eSpark-Backup/anzora-slanukov-design-review/Design Files/QuickSwitchV5-v1.2/Deliverables/Renderings/Isometric.png

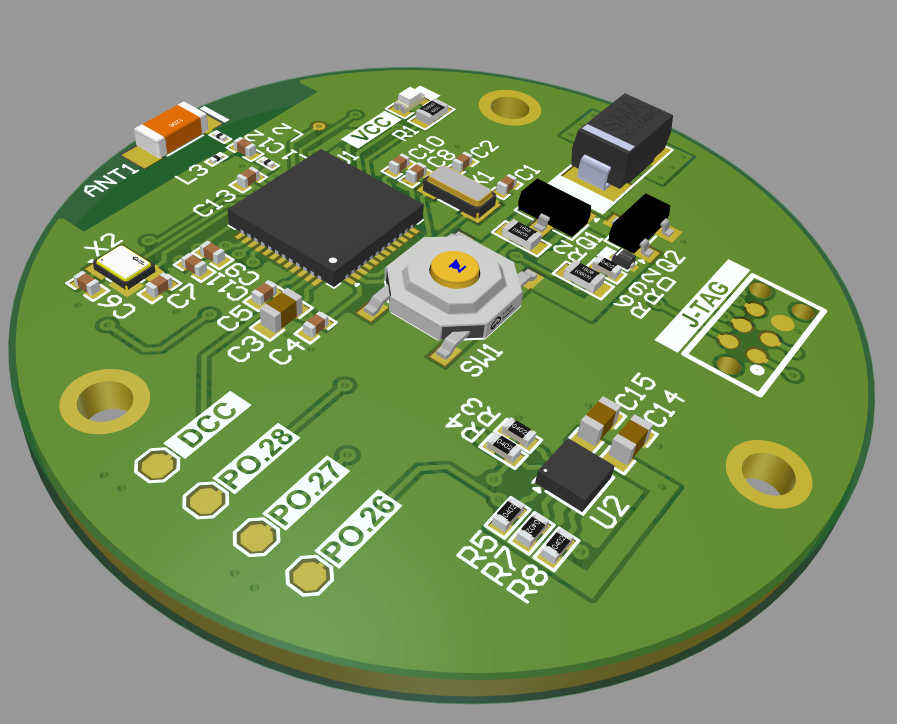
Design Files/QuickSwitchV5-v1.2/Deliverables/Renderings/Isometric.png
