eSpark-Backup/anzora-slanukov-design-review/docs/Client-Files/Original-Design/quickswitch_v5_requirements.docx

Project Overview

QuickSwitch (abbreviated QS) is a Bluetooth door movement detector that is able to detect when a door moves using an accelerometer (LIS2DW12TR) and send keyboard signals to a connected device. When QS detects door movement, it sends keyboard commands Alt+Tab or Cmd+Tab depending on the operating system of the device it is connected to. The QS is meant to operate in low-power mode and uses a CR2032 coin cell battery as its power source.

Functional Requirements

Motion Detection

- The device must detect door opening events using the LIS2DW12TR accelerometer.
- The accelerometer must send a signal to the Soc (NRF52832-QFAA-R) when motion is detected.
- The accelerometer must run in ultra-low power mode.
- The accelerometer must wake-up upon motion being detected.
- The accelerometer must trigger an interrupt to the SoC when motion is detected.
  - During motion detection, the SoC will transition from sleep mode to full power mode.

Bluetooth Communication

- The device must remain connected to the paired device via Bluetooth Low Energy (BLE) at all times unless disconnected by user.
- The device must send a Bluetooth HID signal to simulate Alt+Tab (Windows) or Cmd+Tab (macOS) upon motion detection.

User Input Control

- The device must have a push button to initiate power-on, start-up, and pairing mode selection.
- The device must allow SoC to control shutdown after a set period of inactivity.

Power Management

- The device must use a P-Channel MOSFET latch circuit to manage power efficiently.
- It must be able to latch ON when powered up and shut OFF via firmware control.
- The device must consume minimal current when idle or in standby.

Status Indication

- The device must have a blue LED to indicate power status and pairing mode.

Firmware Update Support

- The device must have a TC2030 programming interface for SWD flashing
- The SoC must support crystal oscillators for accurate timing during flashing and operation

Size and Form Factor

- The PCB must be circular in shape.
- The CR2032 battery holder must be on the opposite (bottom) and the components must be on the top side of the PCB.

Safety and Protection

- The device must include a reverse polarity Schottky diode (SS14) to protect components from battery reversal.
- The device must include ESD protection using the component ESD9B3.3ST5G-ES for critical input lines like the power rail.
- RF components must include impedance matching to ensure a stable Bluetooth connection.

Component Sourcing

- The device must source all components from the JLCPCB parts website.
- The components must be in stock, preferably with availability of over 5000 parts.

Step-by-Step Instructions of Operations

Startup (Power ON) Sequence

1. Device OFF: The P-MOSFET gate is HIGH (via 1MΩ pull-up resistor to BATT+), so the P-MOSFET is OFF (no power to VCC).
2. User Presses Button:
  a. Push button connects BATT+ to N-MOSFET gate, turning the N-MOSFET ON.
  b. N-MOSFET pulls P-MOSFET gate LOW, turning it ON.
  c. Power flows to VCC, SoC powers up.
3. SoC Botts Up:
  a. SoC sets GPIO HIGH to keep N-MOSFET ON, even after button is released.
  b. This latches the power ON.

Shutdown (Power OFF) Sequence

1. SoC sets GPIO LOW:
  a. N-MOSFET turns OFF.
  b. P-MOSFET gate floats HIGH via 1MΩ pull-up.
  c. P-MOSFET turns OFF, cutting power to VCC.
2. Device is now fully OFF, consuming near-zero power.
