eSpark-Backup/anzora-slanukov-design-review/Design Files/QuickSwitchV5-v1.2/Deliverables/Impedance profile/50 OHM nets.png

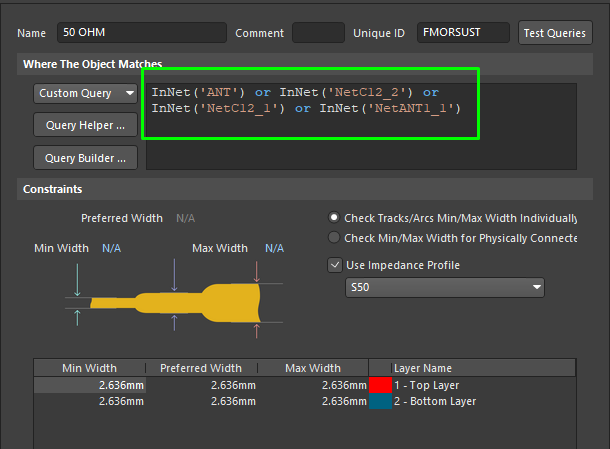
Design Files/QuickSwitchV5-v1.2/Deliverables/Impedance profile/50 OHM nets.png
