eSpark-Backup/anzora-slanukov-design-review/Design Files/QuickSwitchV5-v1.2/Deliverables/Impedance profile/50 OHM.png

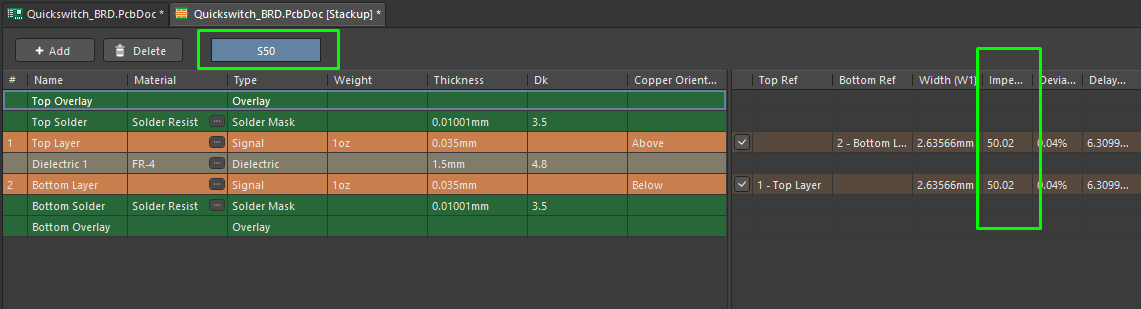
Design Files/QuickSwitchV5-v1.2/Deliverables/Impedance profile/50 OHM.png
