eSpark-Backup/anzora-slanukov-design-review/Design Files/QuickSwitchV5-v1.2/Deliverables/Renderings/2D-View.png

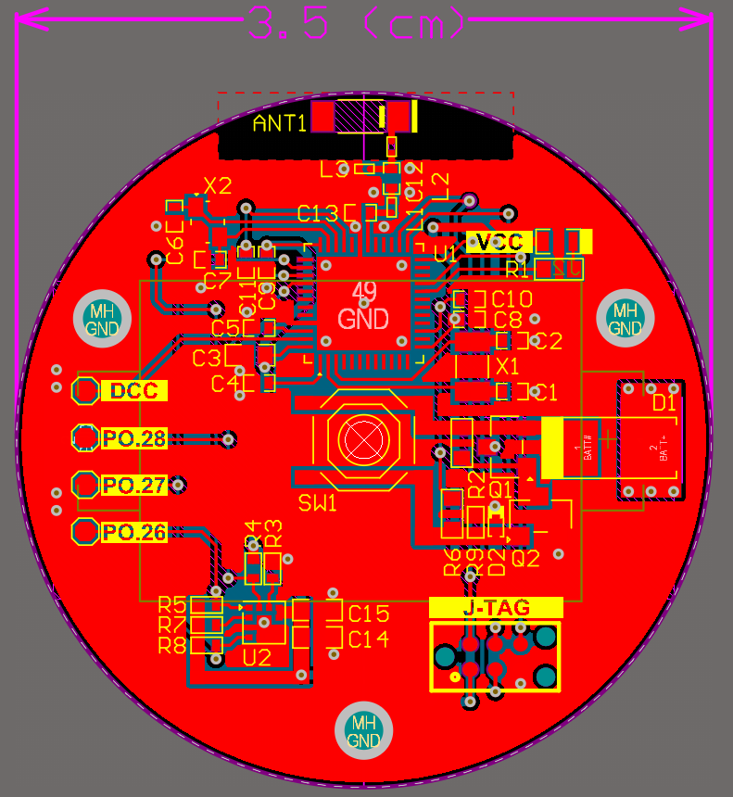
Design Files/QuickSwitchV5-v1.2/Deliverables/Renderings/2D-View.png
