eSpark-Backup/anzora-slanukov-design-review/Design Files/QuickSwitchV5-v1.2/Deliverables/Renderings/3D-BottomView.png

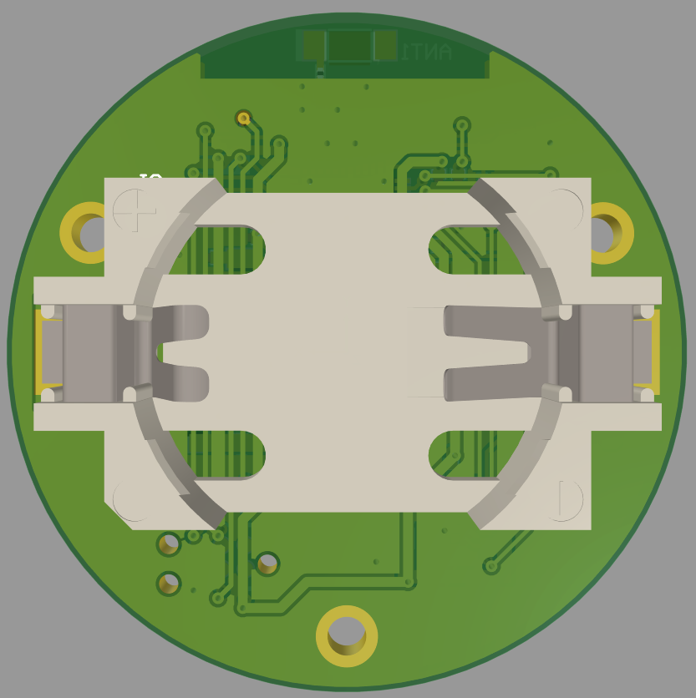
Design Files/QuickSwitchV5-v1.2/Deliverables/Renderings/3D-BottomView.png
