eSpark-Backup/anzora-slanukov-design-review/Design Files/QuickSwitchV5-v1.2/BOM/Client_BOM.xlsx

# | Item Type | Designator | Description | Footprint | Manufacturer Part Number | Manufacturer | Value | Quantity | Remarks
1 | Antenna | ANT1 | RF ANT 2.4GHZ CHIP SOLDER SMD | ANT-1206 | 2450AT18B100E | Johanson | - | 1
2 | Capacitors | ~~C1, C2~~ | ~~CAP CER 13PF 50V C0G/NP0 0402~~ | ~~Cap-0402~~ | ~~CC0402FRNPO9BN130~~ | ~~Yageo~~ | ~~DNP~~ | ~~2~~ | ~~DO NOT PLACE~~
3 | Capacitors | C3 | CAP CER 4.7UF 25V X5R 0603 | Cap-0603 | GRM188R61E475KE11D | Murata | 4.7uF | 1
4 | Capacitors | C4, C8, C9, C10 | CAP CER 0.1UF 50V X7R 0402 | cap-0402 | C1005X7R1H104KT000F | TDK | 100nF | 4
5 | Capacitors | C5 | CAP CER 1UF 16V X5R 0402 | Cap-0402 | CC0402KRX5R7BB105 | Yageo | 1uF | 1
6 | Capacitors | C6, C7 | CAP CER 10PF 50V C0G/NP0 0402 | Cap-0402 | GRM1555C1H100JA01D | Murata | 10pF | 2
7 | Capacitors | C11 | CAP CER 100PF 50V C0G/NP0 0402 | Cap-0402 | 04025A101JAT2A | Kyocera AVX | 100pF | 1
8 | Capacitors | C12 | CAP CER 2.2PF 50V C0G/NP0 0402 | Cap-0402 | GRM1555C1H2R2BA01D | Murata | 2.2pF | 1
9 | Capacitors | C13 | CAP CER 0.8PF 50V C0G/NPO 0402 | Cap-0402 | CC0402BRNPO9BNR80 | Yageo | 0.8pF | 1
10 | Capacitors | C14 | CAP CER 0.1UF 50V Y5V 0603 | Cap-0603 | CC0603ZRY5V9BB104 | Yageo | 0.1uF | 1
11 | Capacitors | C15 | 10V 10uF X5R ±10% 0603 Multilayer Ceramic Capacitors MLCC - SMD/SMT ROHS | Cap-0603 | CGA0603X5R106K100JT | HRE | 10uF | 1
12 | Diode | D1 | 40V Independent Type 1A 550mV@1A SMA(DO-214AC) Schottky Diodes ROHS | SMA(DO-214AC) | SS14 | MDD(Microdiode Semiconductor) | - | 1
13 | Diode | D2 | 6A 80W 10V 3.7V Bidirectional 3.3V SOD-923 ESD and Surge Protection (TVS/ESD) ROHS | SOD-923. | ESD9B3.3ST5G-ES | ElecSuper | - | 1
14 | Connector | ~~J1~~ | ~~-~~ | ~~Custom~~ | ~~-~~ | ~~-~~ | ~~DNP~~ | ~~1~~ | ~~DO NOT PLACE~~
15 | Connector | J2 | Battery base CR2032 SMD Battery Connectors ROHS | Custom | CR2032-BS-6-1 | Q&J | - | 1
16 | Inductors | L1, L2 | FIXED IND 3.9NH 350MA 350MOHM SM | IND-0201 | LQP03TG3N9B02D | Murata | 3.9nH | 2
17 | Inductor | ~~L3~~ | ~~FIXED IND 2.7NH 500MA 200MOHM SM~~ | ~~IND-0201~~ | ~~LQP03TN2N7B02D~~ | ~~Murata~~ | ~~DNP~~ | ~~1~~ | ~~DO NOT PLACE~~
18 | LED | LED1 | 20mA 300mcd Colorless Transparent Lens -20℃~+85℃ Positive Stick 455nm~475nm Blue 120° 70mW 3.3V 0603 LED Indication - Discrete ROHS | LED-0603 | XL-1608UBC-04 | XINGLIGHT | - | 1
19 | Mosfet | Q1 | Trans Mosfet P-ch 30V 4A 3-PIN SOT-23 T/r | SOT-23 | AO3401A | Alpha & Omega Semiconductor | - | 1
20 | Mosfet | Q2 | MOSFET N-CH 50V 200MA SOT-23 | SOT-23 | BSS138LT1G | ON Semiconductor | - | 1
21 | Resistor | R1 | 100mW Thick Film Resistors 75V ±100ppm/℃ ±1% 330Ω 0603 Chip Resistor - Surface Mount ROHS | Res-0603 | 0603WAF3300T5E | Royal Electronic Factory | 330R | 1
22 | Resistor | R2 | 100mW Thick Film Resistors ±100ppm/℃ ±1% 1MΩ 0603 Chip Resistor - Surface Mount ROHS | Res-0603 | 0603WAF1004T5E | UNI-ROYAL(Uniroyal Elec) | 1M | 1
23 | Resistor | R3, R4, R7, R9 | RES SMD 10K OHM 0.5% 1/16W 0402 | Res-0402 | RE0402DRE0710KL | Yageo | 10K | 4
24 | Resistor | R5, R8 | RES 4.7K OHM 1% 1/16W 0402 | Res-0402 | RC0402FR-074K7L | Yageo | 4.7K | 2
25 | Resistor | R6 | RES 470 OHM 1% 1/10W 0603 | Res-0603 | RC0603FR-07470RL | Yageo | 470R | 1
26 | Switch | SW1 | None Without bracket 50mA 5.1mm 100000 Times 160gf 12V 5.1mm 1.5mm Round Button Standing paste SPST SMD Tactile Switches ROHS | Custom | TS-1187A-B-A-B | XKB | - | 1
27 | IC | U1 | IC RF TXRX+MCU BLE 48QFN | QFN-48-EP(6x6) | NRF52832-QFAA-R | Nordic Semiconductor | - | 1
28 | IC | U2 | ACCEL 2-16G I2C/SPI 12LGA | 12-LGA (2x2) | LIS2DW12TR | STMicroelectronics | - | 1
29 | ~~Crystals~~ | ~~X1~~ | ~~32.768kHz Surface Mount Crystal 12.5pF ±20ppm SMD3215-2P Crystals ROHS~~ | ~~SMD3215-2P~~ | ~~Q13FC13500004~~ | ~~Epson~~ | ~~DNP~~ | ~~1~~ | ~~DO NOT PLACE~~
30 | Crystal | X2 | 32MHz Surface Mount Crystal 12pF ±10ppm ±10ppm SMD2016-4P Crystals ROHS | SMD2016-4P | TAXM32M4ZFBCCT2T | Yajingxin | - | 1
31 | Peripheral | - | “No Legs” 6-pin Plug-of-Nails™ Cable fitted with a 6-pin 0.1″ pitch ribbon connector | Custom | TC2030-IDC-NL | Tag-Connect LLC | - | 1 | Tag Connect (https://www.tag-connect.com/product/tc2030-idc-nl)
32 | Peripheral | - | BATTERY LITHIUM 3V COIN 20MM | Custom | CR2032 | - | - | 1 | Aliexpress (https://vi.aliexpress.com/item/1005007515412606.html)
