eSpark-Backup/anzora-slanukov-design-review/docs/Client-Files/Original-Design/qs_components.xlsx

Quantity | JLCPCB Part # | Component Name | Description
1 | C77540 | NRF52832-QFAA-R | nRF SoC
1 | C189624 | LIS2DW12TR | Accelerometer
1 | C14663 | CC0603KRX7R9BB104 | Decoupling Capacitor (C1)
1 | C19702 | CL10A106KP8NNNC | Bulk Capacitor (C2)
2 | C23162 | 0603WAF4701T5E | I²C Pull-up Resistors (R1, R2)
3 | C25804 | 0603WAF1002T5E | 10kΩ Interrupt Pull-up Resistors (R3, R4, Optional) and CS (Chip Select) Pull-up Resistor (R5)
1 | C70377 | CR2032-BS-6-1 | CR2032 Battery Holder
1 | C293767 | ANT3216LL00R2400A | Bluetooth Chip Antenna
1 | C18216 | LQG15HS2N0S02D | Chip Antenna Inductor
1 | C1558 | 0402CG2R0C500NT | C1 Capacitor
1 | C1550 | 0402CG1R0C500NT | C2 Capacitor
1 | C14663 | CC0603KRX7R9BB104 | C3 100nF Capacitor
1 | C965807 | XL-1608UBC-04 | Blue LED
1 | C23138 | 0603WAF3300T5E | 330Ω Resistor
1 | C318884 | TS-1187A-B-A-B | Push Button
1 | C347476 | AO3401A | P-Channel MOSFET
1 | C3008053 | 2N7002K | N-Channel MOSFET
1 | C25804 | 0603WAF1002T5E | 10kΩ Resistor
1 | C25803 | 0603WAF1003T5E | 100kΩ Resistor
1 | C14663 | CC0603KRX7R9BB104 | 100nF Capacitor
1 | C1705 | CL10A475KP8NNNC | 4.7uF Capacitor
1 | C2480 | SS14 | Reverse-Polarity Protection Schottky Diode
1 | C5180230 | ESD9B3.3ST5G-ES | TVS/ESD Surge Protector
1 | C21190 | 0603WAF1001T5E | 1kΩ Resistor
1 | C19702 | CL10A106KP8NNNC | 10uF Decoupling Capacitor
1 | C22935 | 0603WAF1004T5E | 1MΩ Resistor for Gate Pull-Down
1 | C15849 | CL10A105KB8NNNC | 1uF Power Stability Capacitor
1 | C388797 | TAXM32M4ZFBCCT2T | 32 MHz Crystal
2 | C76946 | GRM1555C1H100JA01D | C0G Dielectric 10pF Capacitor
1 | C22935 | 0603WAF1004T5E | 1MΩ latch-up prevention DC resistor
1 | C32346 | Q13FC13500004 | 32.768kHz Surface Mount Crystal
2 | C541433 | CC0402FRNPO9BN130 | 13pF NP0 SMT Capacitor
