eSpark-Backup/anzora-slanukov-design-review/Design Files/QuickSwitchV5-v1.2/Deliverables/Supporting Files/Quickswitch_BRD.step

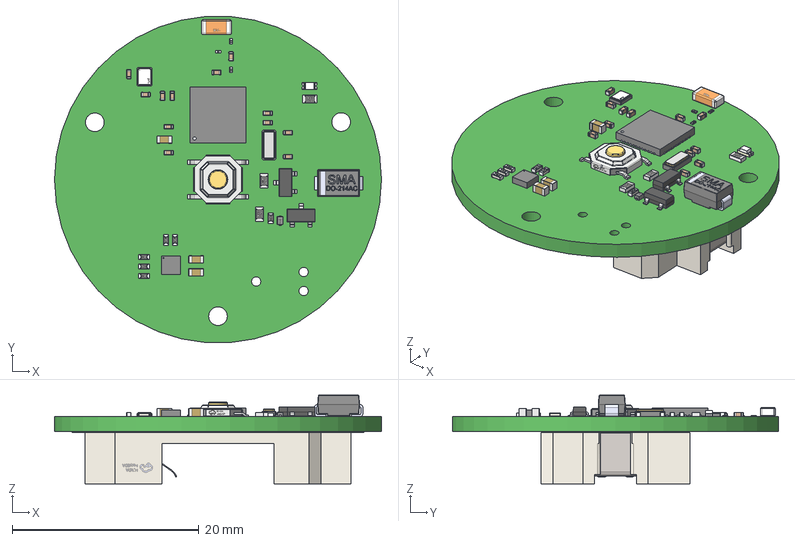
[picture p7: CAD file, 2025-04-03]
Design Files/QuickSwitchV5-v1.2/Deliverables/Supporting Files/Quickswitch_BRD.step
35.0 x 34.9 x 9.49 mm
Ferrite x 3
User Library-NDK_NX3215SA
LIS2DW12TR
User Library-RES_1005-0402 x 6
User Library-RESC1608X05N x 3
CircuitWorks-SOT-23 x 2
User Library-LED SMD0603
SOLID.step
User Library-DIODE_SOD-923
SMA (DO-214AC)
User Library-CAPC1608X09 x 3
User Library-Capacitor 0402 x 12
User Library-1206 SMD Capacitor
