eSpark-Backup/anzora-slanukov-design-review/(list of files, cad)

Other CAD files:
Design Files/QuickSwitchV5-v1.2/Deliverables/Supporting Files/Quickswitch_BRD.DWG
Design Files/QuickSwitchV5-v1.2/Deliverables/Supporting Files/Quickswitch_BRD.DXF
