eSpark-Backup/anzora-slanukov-design-review/docs/Client-Files/Original-Design/full_schematic_v1.pdf

R7

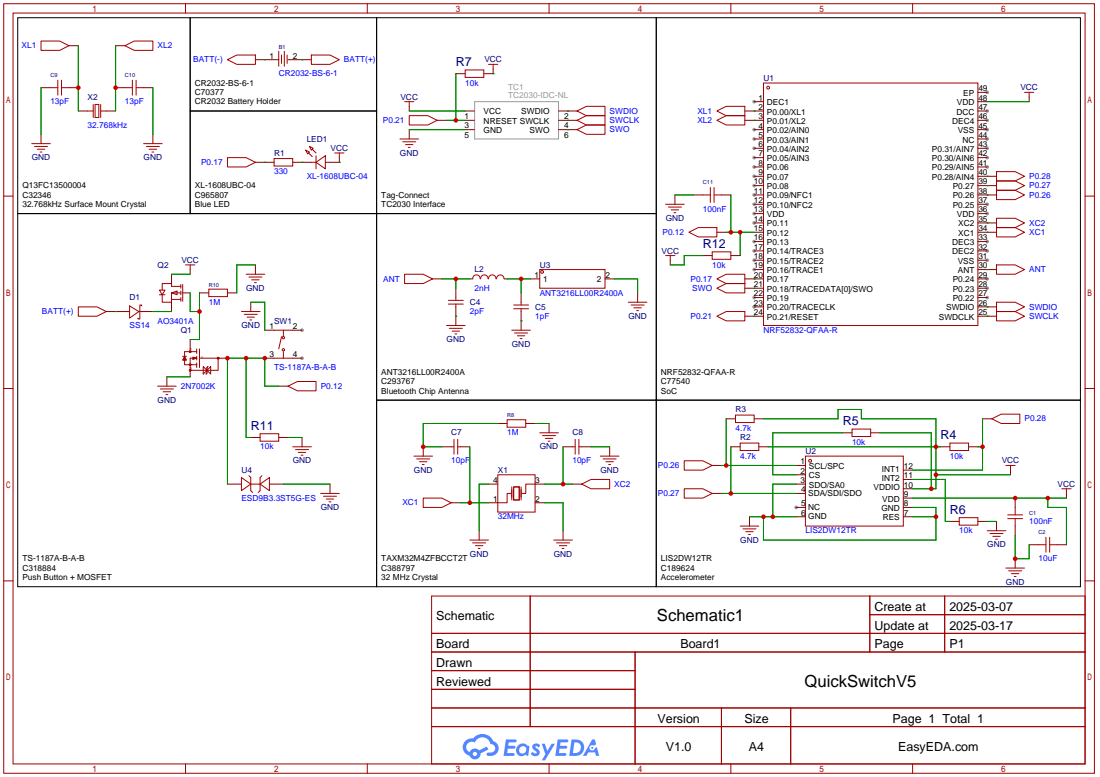
[picture p8: page 1]

Schematic | Schematic1 | Create at | 2025-03-07

Update at | 2025-03-17

Board | Board1 | Page | P1
Drawn | | QuickSwitchV5
Reviewed

Version | Size | Page 1 Total 1
V1.0 | A4 | EasyEDA.com
