eSpark-Backup/anzora-slanukov-design-review/Design Files/QuickSwitchV5-v1.2/Deliverables/Schematics/Assembly Drawings.pdf

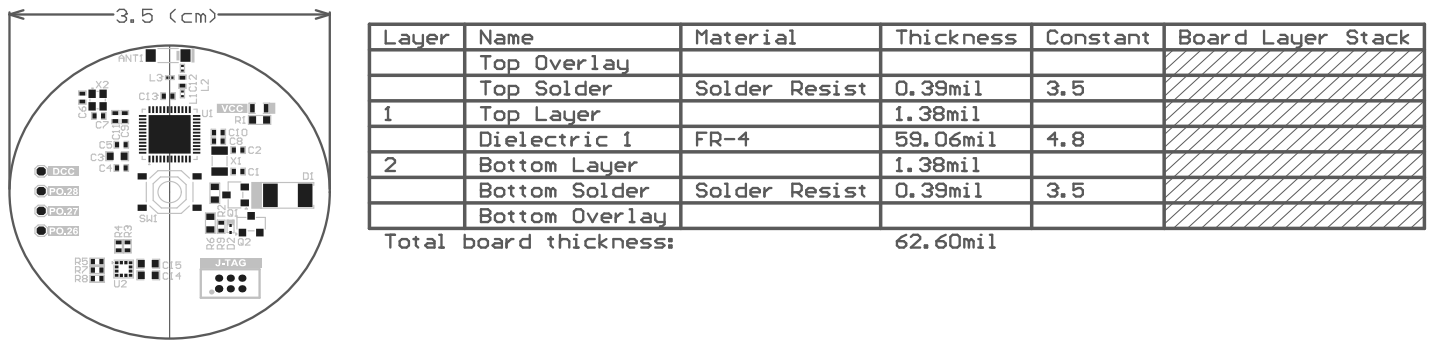
[picture p9: page 1]

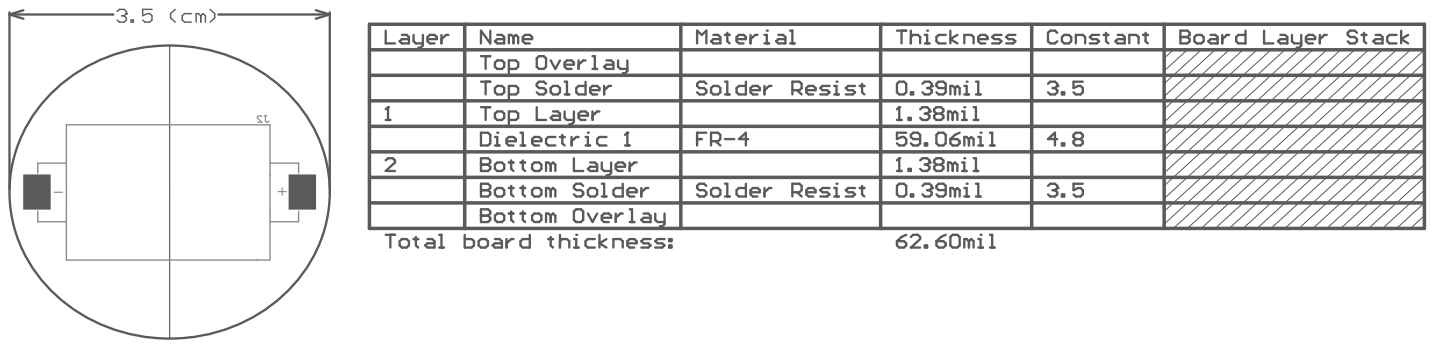
[picture p10: page 2]
