eSpark-Backup/anzora-slanukov-design-review/Design Files/QuickSwitchV5-v1.2/Deliverables/Schematics/quickswitchv5-v1.2.pdf

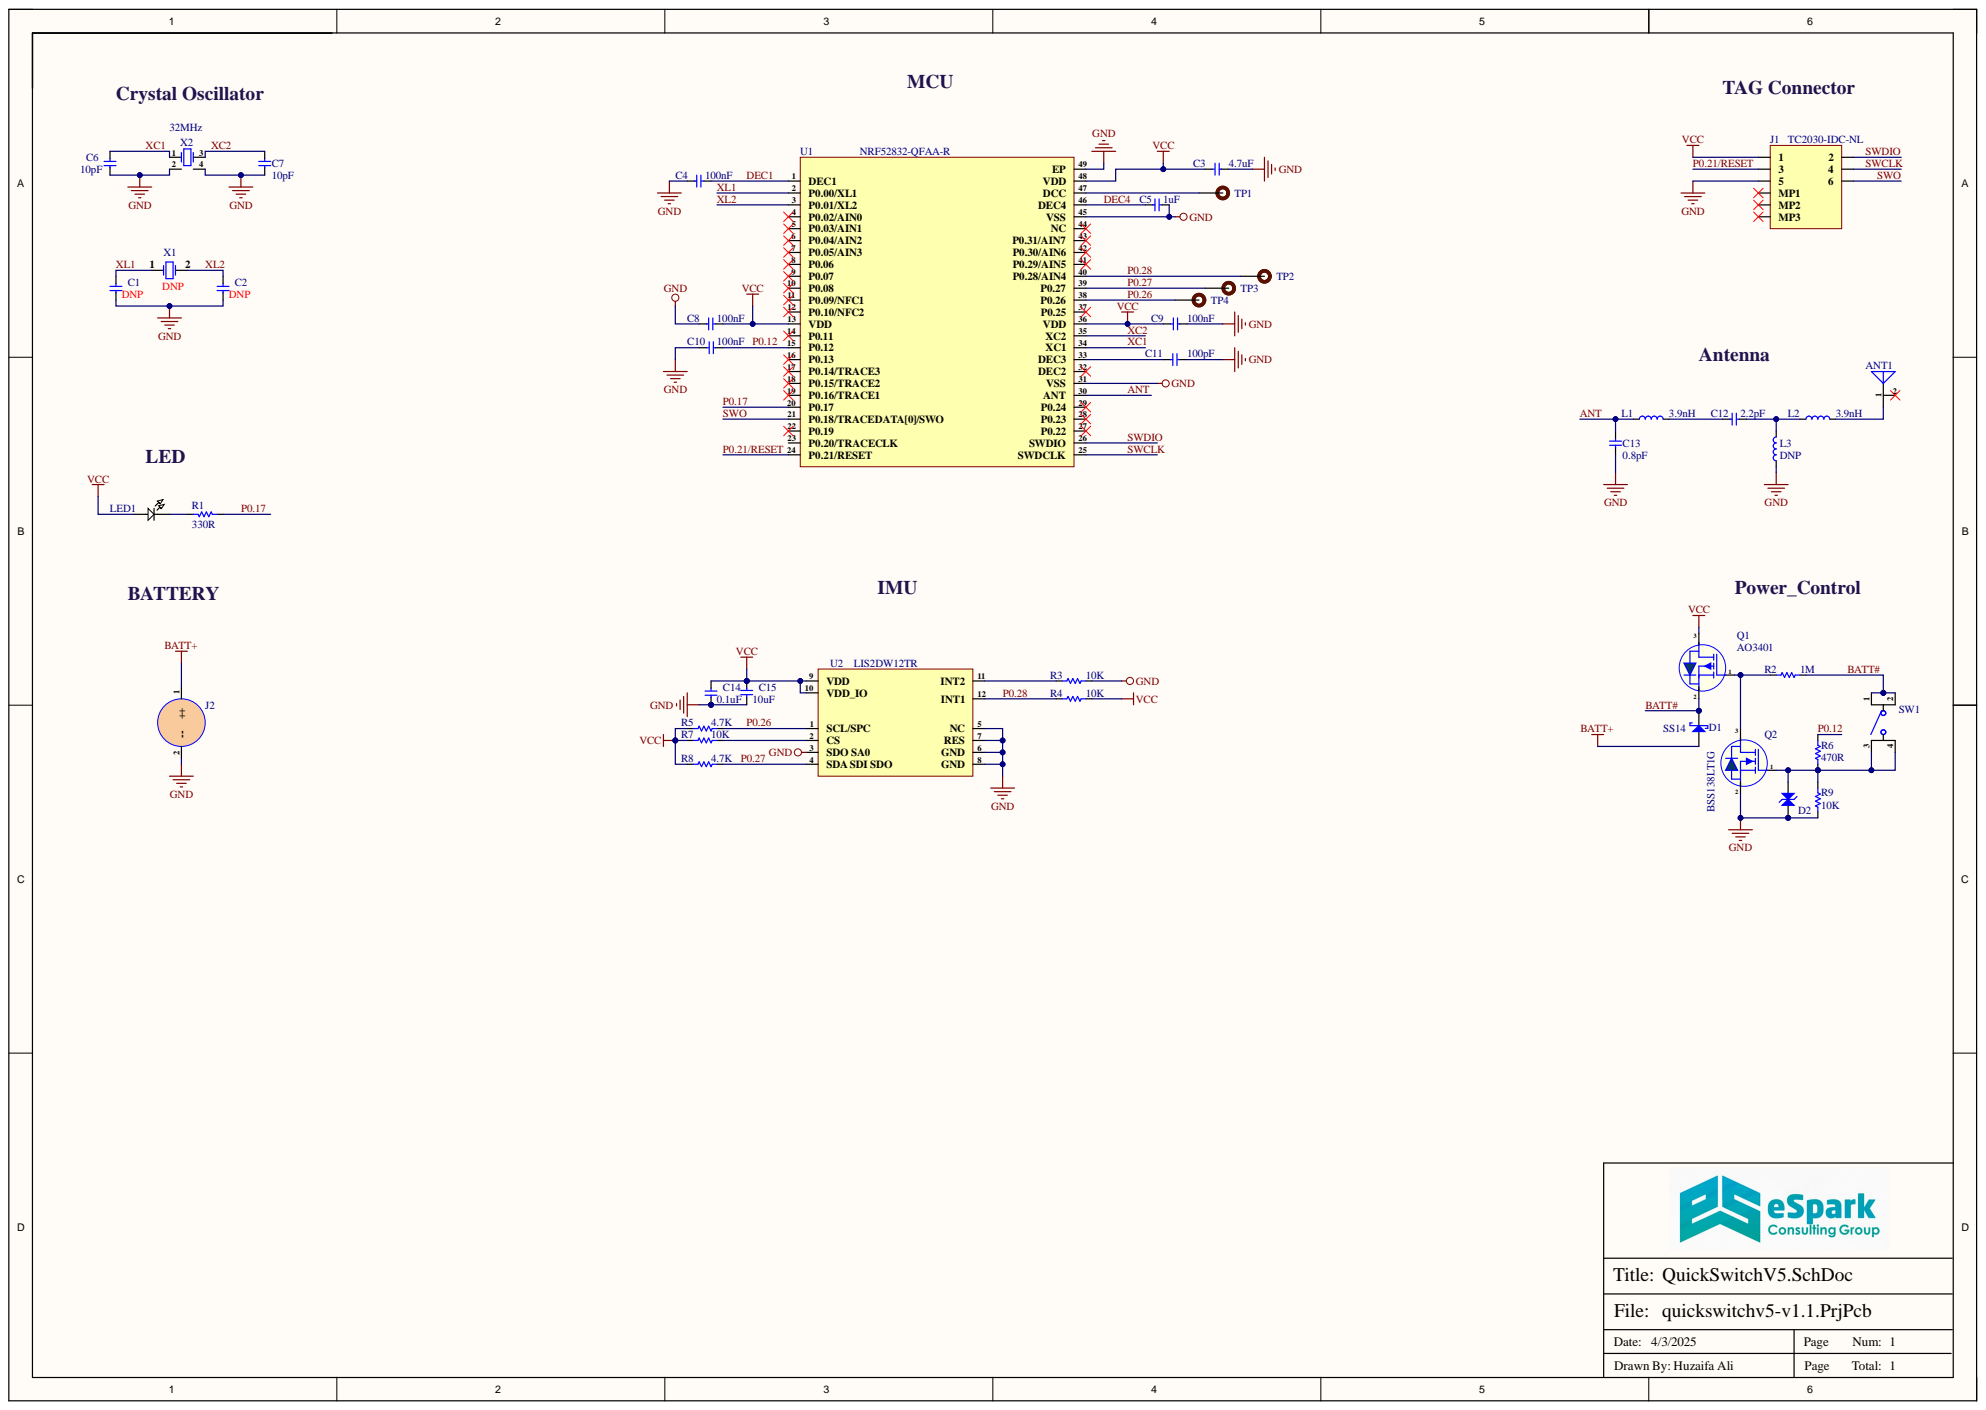
[picture p11: page 1]

Date : 4/3 /2 0 2 5 | Pag e Nu m : 11

Drawn By: Huzaifa Ali | Pag e Total :
