eSpark-Backup/anzora-slanukov-design-review/(list of files, drawings)

Other design files:
Design Files/BLE_Quick Switch V5/BLE_Quick Switch V5.PrjPcb
Design Files/QuickSwitchV5-v1.2/Quickswitch_BRD.PcbDoc
Design Files/QuickSwitchV5-v1.2/quickswitchv5-v1.2.PrjPcb
Design Files/QuickSwitchV5-v1.2/QuickSwitchV5.SchDoc
