eSpark-Backup/anzora-slanukov-design-review/(commit log)

2025-03-19 Add: original design and gitignore
    [qs_components.xlsx]
2025-03-20 #3 added controller IMU and Power sheet (in progress)
    [BLE_Quick Switch V5.PrjPcb, Controller_Sheet.SchDoc, IMU_Sheet.SchDoc, Power_Sheet.SchDoc]
2025-03-21 #3 Updated Schematic design ( in progress )
    [Controller_Sheet.SchDoc, IMU_Sheet.SchDoc, Power_Sheet.SchDoc, quickswitchv5-v1.1.PrjPcb]
2025-03-24 #3 Updated Power and Controller sections (in progress)
    [Controller_Sheet.SchDoc, IMU_Sheet.SchDoc, Power_Sheet.SchDoc, QuickSwitchV5.SchDoc, quickswitchv5-v1.1.PrjPcb]
2025-03-25 #3 Updated Schematic design (done)
    [QuickSwitchV5.SchDoc, quickswitchv5-v1.1.PrjPcb]
2025-03-25 #4 Component placement in progress
    [QuickSwitchV5.SchDoc, Quickswitch_BRD.PcbDoc, quickswitchv5-v1.1.PrjPcb]
2025-03-26 #3 Updated Antenna, RTC Section and PCB design updated
    [QuickSwitchV5.SchDoc, Quickswitch_BRD.PcbDoc]
2025-03-26 #3 Updated PRJ file pushed (done)
    [quickswitchv5-v1.1.PrjPcb]
2025-03-27 #4 Routing in progress
    [Quickswitch_BRD.PcbDoc]
2025-03-30 #4 PCB Completed, BOM and Deliverables Generated
    [Centroid_File.csv, Cleint_BOM.xlsx, Pick Place for Quickswitch_BRD.csv, Quickswitch_BRD.DWG, Quickswitch_BRD.DXF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]
2025-04-01 Replace: schematic pdf files
2025-04-03 #5 updated Antenna matching circuitry Also updated PDF schematic
    [QuickSwitchV5.SchDoc, quickswitchv5-v1.1.PrjPcb]
2025-04-03 #4 Design completed. Deliverables generated
    [Centroid.csv, Pick Place for Quickswitch_BRD.csv, Quickswitch_BRD.DWG, Quickswitch_BRD.DXF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]
2025-04-03 #5 updated BOM file
    [Cleint_BOM.xlsx, QuickSwitchV5.SchDoc]
2025-04-03 Change: version number due to antenna updates in schematic and PCB
    [quickswitchv5-v1.2.PrjPcb]
2025-04-03 Add: version number in main folder
    [Centroid.csv, Cleint_BOM.xlsx, Pick Place for Quickswitch_BRD.csv, QuickSwitchV5.SchDoc, Quickswitch_BRD.DWG, Quickswitch_BRD.DXF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]
2025-04-07 #6 Peripherals added in Client BOM
    [Cleint_BOM.xlsx, Client_BOM.xlsx, JLCPCB_BOM.xlsx]
